LesKaribous/Karibous-2025-PAMI/README.md

# Project-Template
Template de projet avec documentation
