LesKaribous/Karibous-2025-PAMI/ECAD/MiniAmpli-2025/DFR0299/DFR0299.step

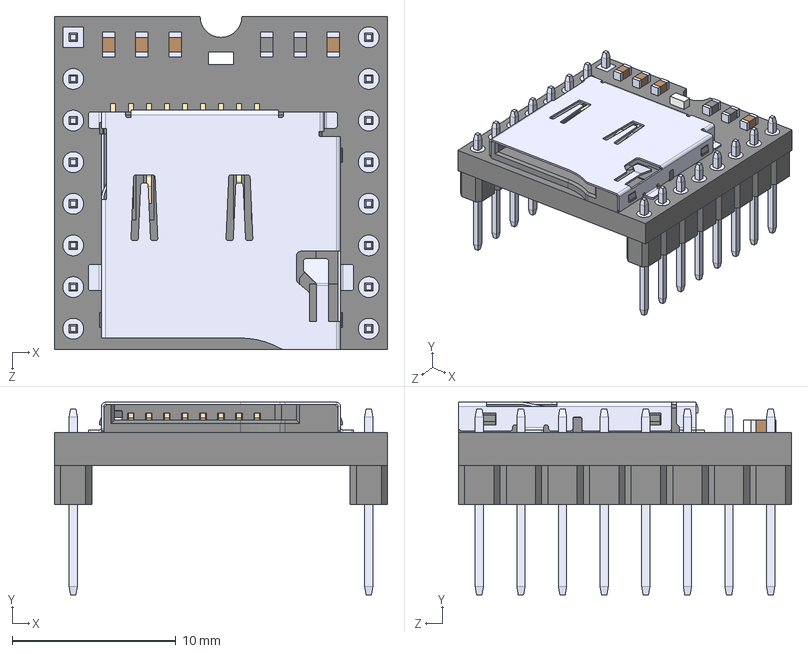
[picture p1: CAD file, 2025-03-02]
ECAD/MiniAmpli-2025/DFR0299/DFR0299.step
20.3 x 11.8 x 20.3 mm
