LesKaribous/Karibous-2025-PAMI/MCAD/3dprint/3dPrint-PAMI-2025.3mf

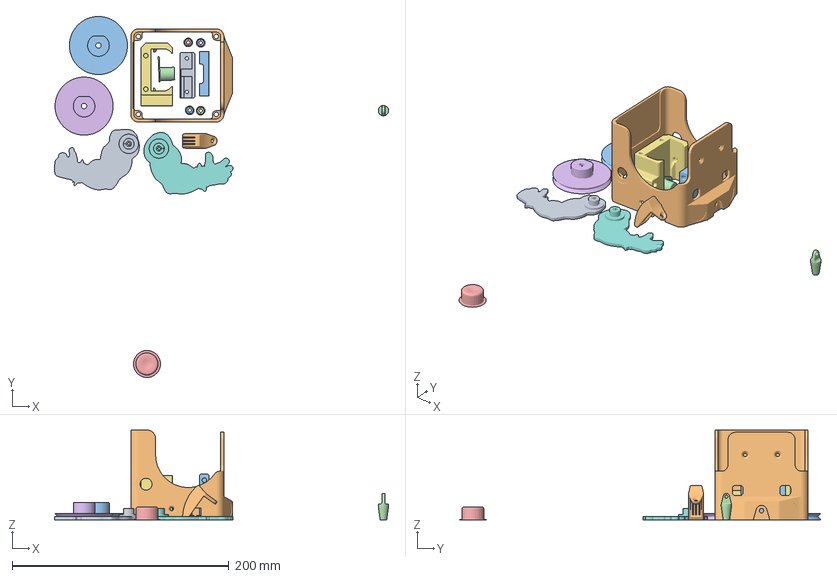
[picture p2: CAD file, 2024-11-29]
MCAD/3dprint/3dPrint-PAMI-2025.3mf
308.8 x 333.4 x 83.0 mm
PAMI-2025-Bras.stl
PAMI-2025-Bras02.stl
