LesKaribous/Karibous-2025-PAMI/MCAD/electronics/support-sensor.FCStd

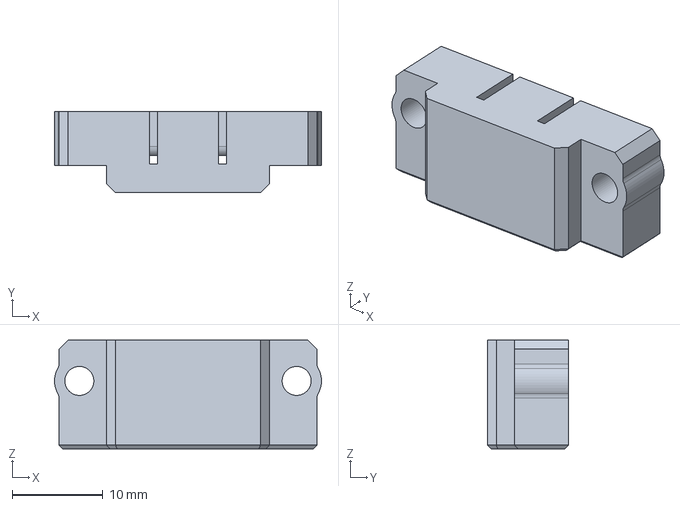
[picture p3: CAD file, 2025-04-25]
MCAD/electronics/support-sensor.FCStd
29.5 x 9.00 x 12.0 mm
