LesKaribous/Karibous-2025-PAMI/MCAD/exports/PAMI-2025-MotorisationRoue60mm.step

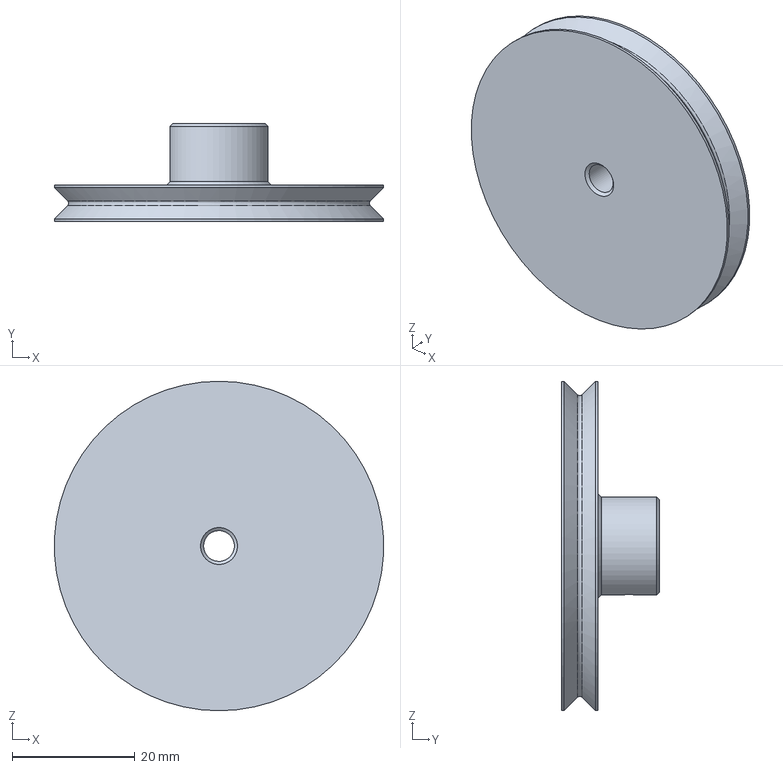
[picture p4: CAD file, 2024-11-04]
MCAD/exports/PAMI-2025-MotorisationRoue60mm.step
53.5 x 16.0 x 53.6 mm
