LesKaribous/Karibous-2025-PAMI/MCAD/mini-ampli/mini-ampli-2025.FCStd

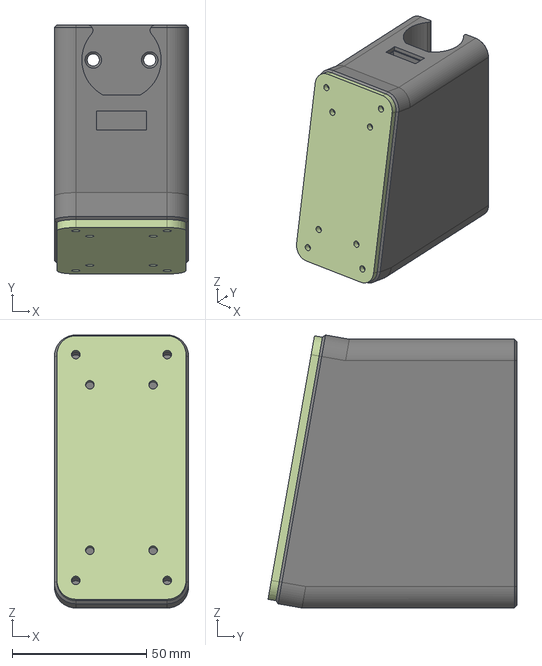
[picture p5: CAD file, 2025-03-02]
MCAD/mini-ampli/mini-ampli-2025.FCStd
50.0 x 92.6 x 101.6 mm
Grille
