LesKaribous/Karibous-2025-PAMI/MCAD/prototypes/proto-01.FCStd

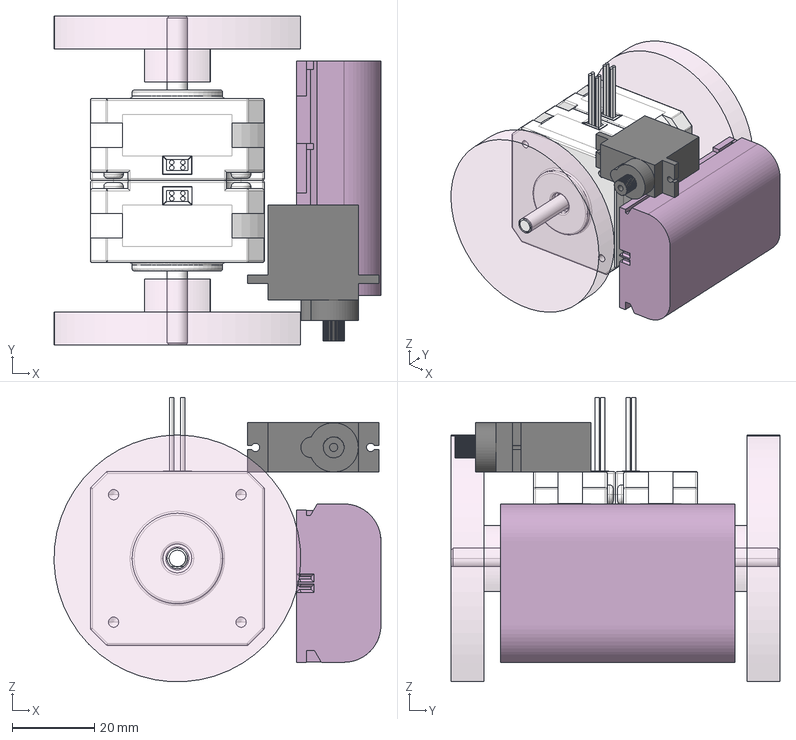
[picture p6: CAD file, 2024-11-02]
MCAD/prototypes/proto-01.FCStd
79.5 x 80.0 x 69.1 mm
17HS08-1004S x 2
Roue60mm x 2
mg90s
CanonLPE6-Canon
