LesKaribous/Karibous-2025-PAMI/MCAD/electronics/mg90s.step

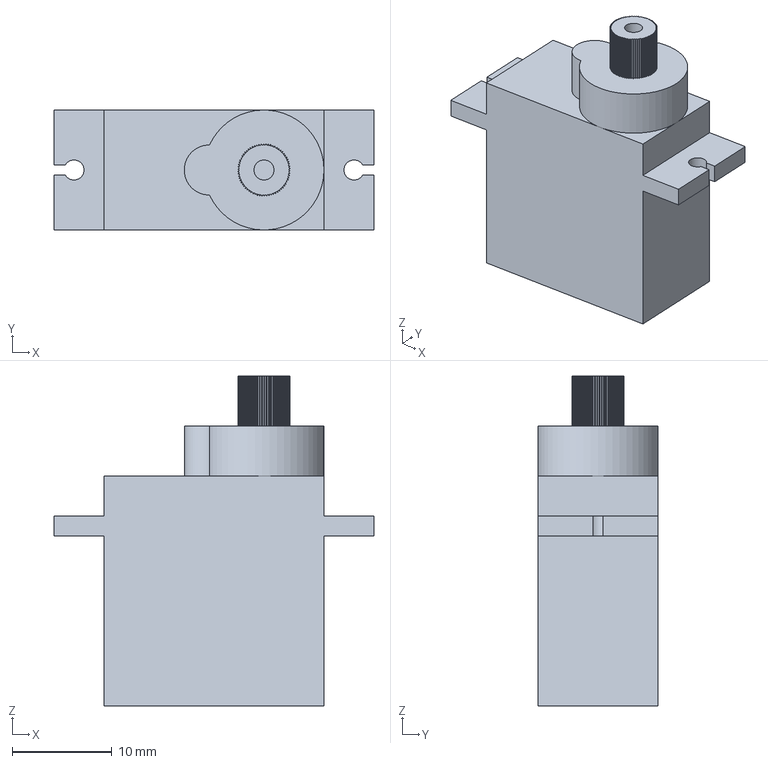
[picture p7: CAD file, 2024-10-12]
MCAD/electronics/mg90s.step
32.0 x 12.0 x 33.0 mm
