LesKaribous/Karibous-2025-PAMI/MCAD/electronics/17HS08-1004S.step

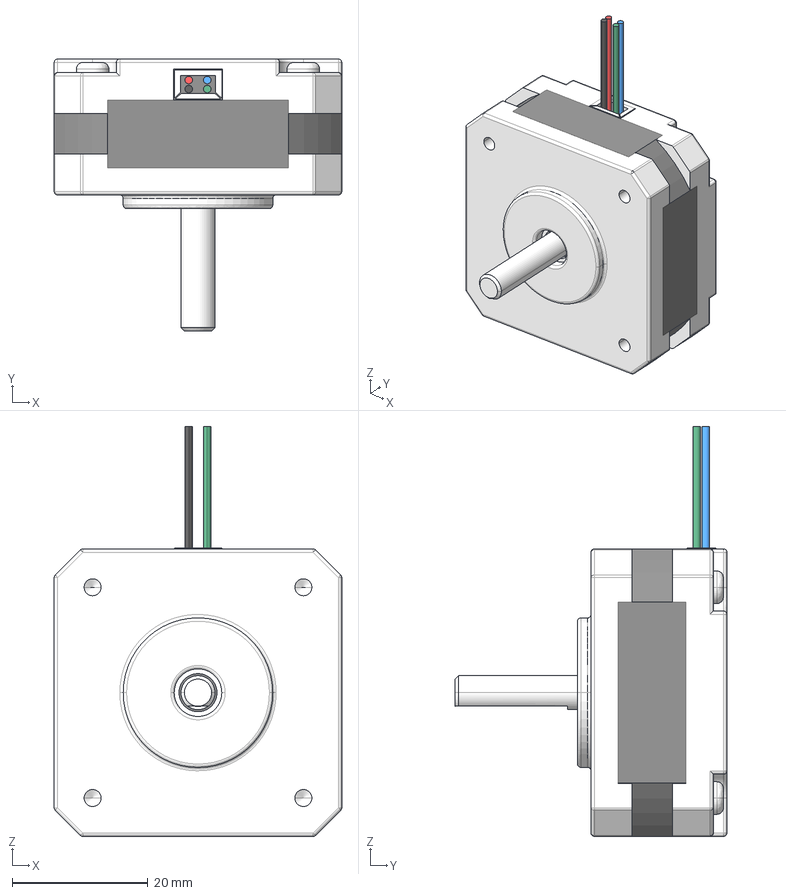
[picture p8: CAD file, 2024-10-11]
MCAD/electronics/17HS08-1004S.step
42.3 x 40.0 x 60.3 mm
