LesKaribous/Karibous-2025-PAMI/ECAD/MainBoard-PAMI-2025/MainBoard-PAMI-2025.kicad_pcb

## KiCad design ECAD/MainBoard-PAMI-2025/MainBoard-PAMI-2025.kicad_pcb (2025-06-07)

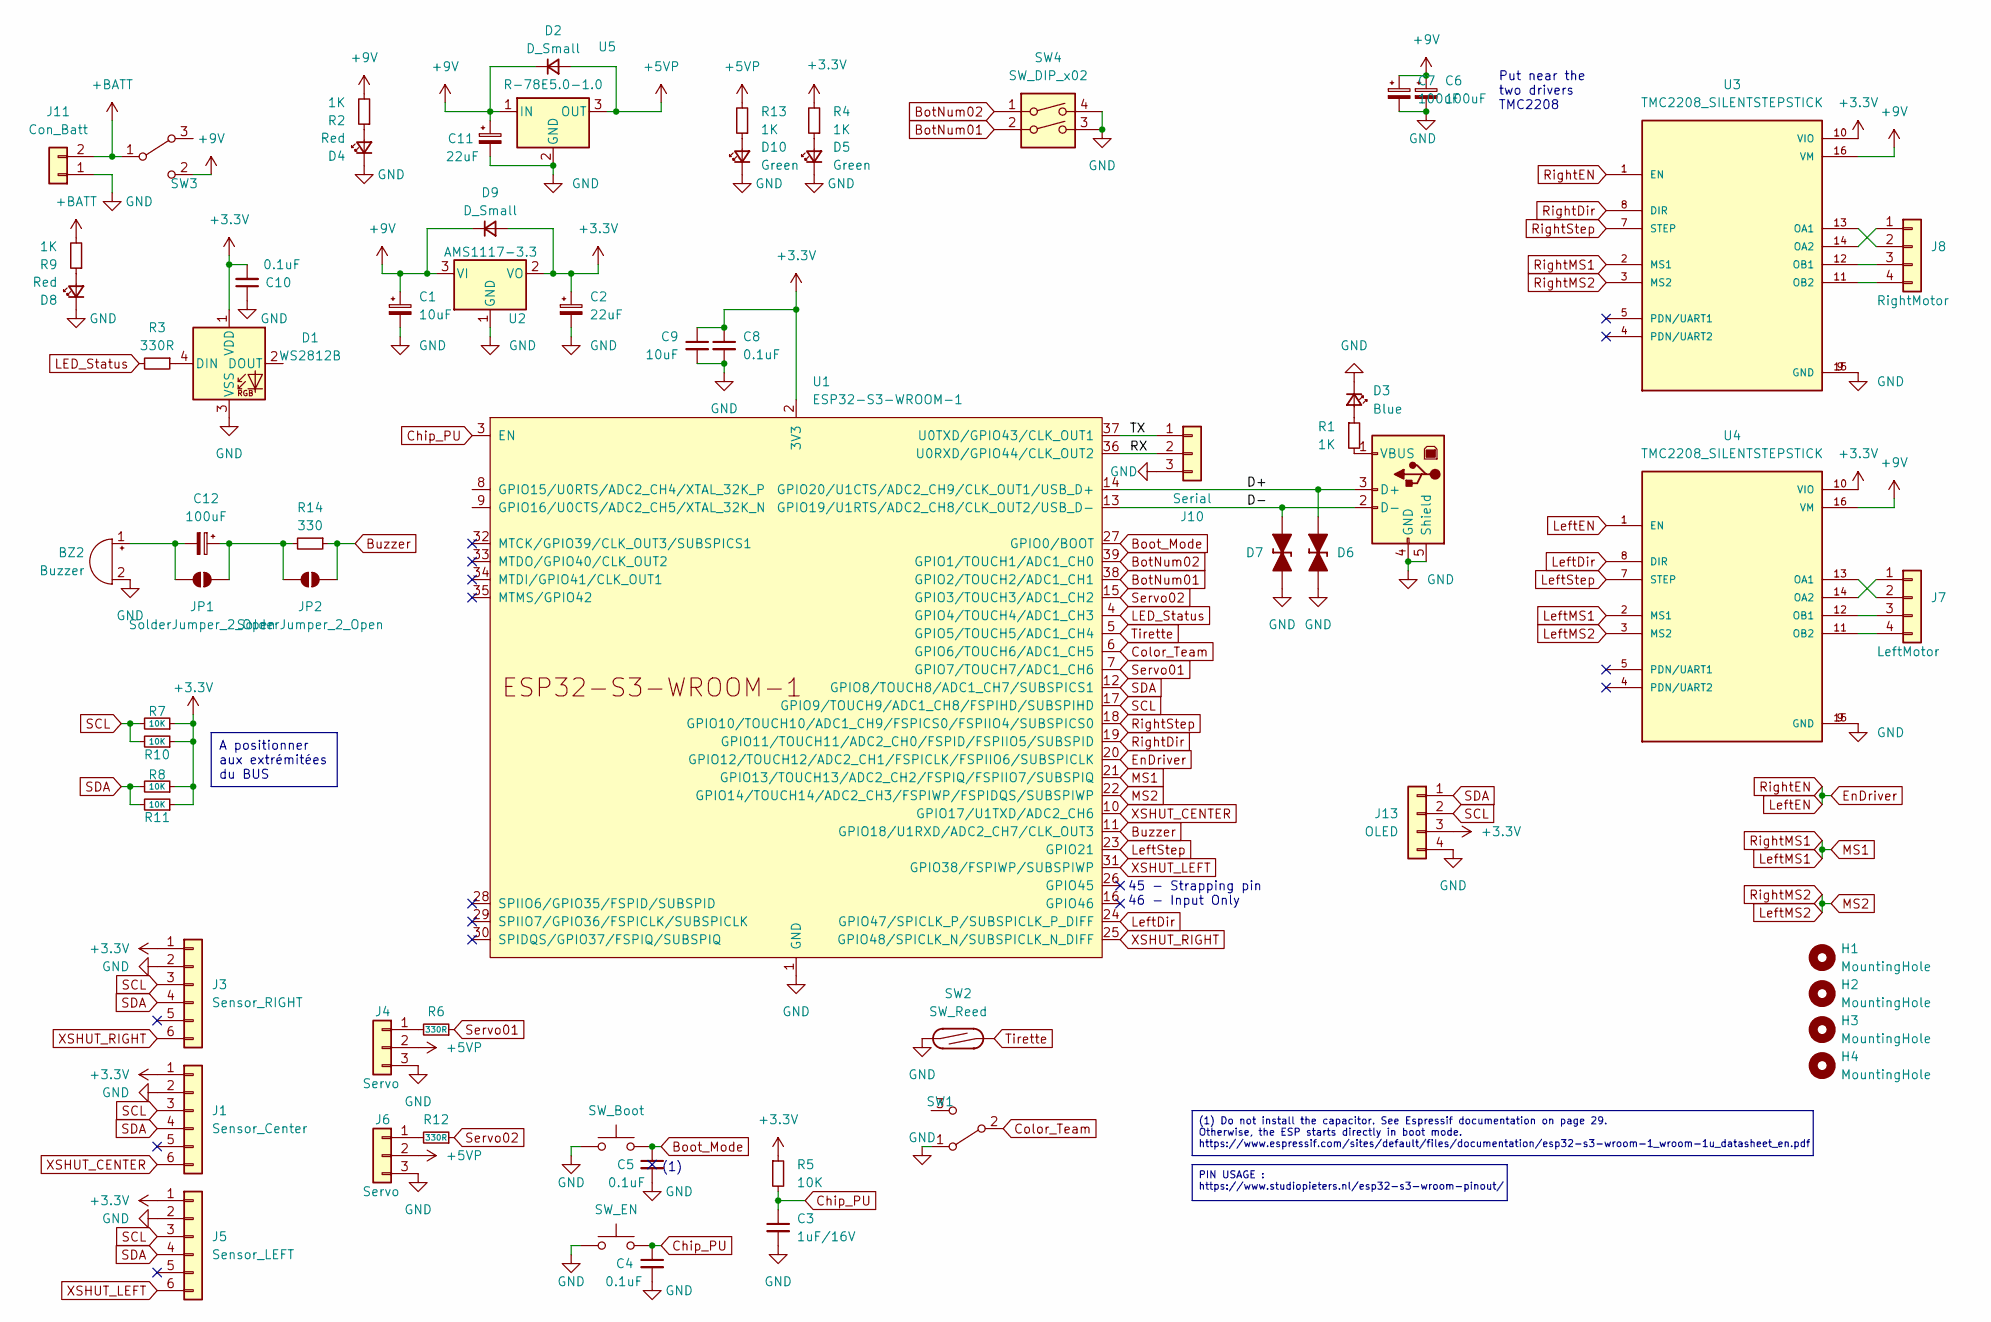
[picture p9: schematic MainBoard-PAMI-2025.kicad_sch]

Parts:
BZ2: Buzzer; Buzzer_12x9.5RM7.6
C1: 10uF; CP_Elec_5x5.4
C2: 22uF; CP_EIA-3528-12_Kemet-T_Pad1.50x2.35mm_HandSolder
C3: 1uF/16V; C_1206_3216Metric
C4, C5, C10: 0.1uF; C_1206_3216Metric
C6, C7: 100uF; CP_Radial_D8.0mm_P3.50mm
C8: 0.1uF; C_1206_3216Metric_Pad1.33x1.80mm_HandSolder
C9: 10uF; C_1206_3216Metric_Pad1.33x1.80mm_HandSolder
C11: 22uF; CP_Elec_5x5.4
C12: 100uF; CP_Elec_5x5.4
D1: WS2812B; LED_WS2812B_PLCC4_5.0x5.0mm_P3.2mm
D2, D9: D_Small; D_SMA_Handsoldering
D3: Blue; LED_1206_3216Metric
D4, D8: Red; LED_1206_3216Metric
D5, D10: Green; LED_1206_3216Metric
D6, D7: D_TVS_Bidirectional_Generic; D_SOD-523
H1, H2, H3, H4: MountingHole; MountingHole_3.2mm_M3
J1: Sensor_Center; VL53 Bottom Entry Version
J2: USB_B; USB_B_Lumberg_2411_02_Horizontal
J3: Sensor_RIGHT; VL53 Bottom Entry Version
J4, J6: Servo; PinHeader_1x03_P2.54mm_Vertical
J5: Sensor_LEFT; VL53 Bottom Entry Version
J7: LeftMotor; PinHeader_1x04_P2.54mm_Vertical
J8: RightMotor; PinHeader_1x04_P2.54mm_Vertical
J10: Serial; PinHeader_1x03_P2.54mm_Vertical
J11: Con_Batt; Molex_KK-254_AE-6410-02A_1x02_P2.54mm_Vertical
J13: OLED; PinSocket_1x04_P2.54mm_Vertical
JP1, JP2: SolderJumper_2_Open; SolderJumper-2_P1.3mm_Open_RoundedPad1.0x1.5mm
R1, R2, R4, R9, R13: 1K; R_1206_3216Metric_Pad1.30x1.75mm_HandSolder
R3, R6, R12: 330R; R_1206_3216Metric_Pad1.30x1.75mm_HandSolder
R5, R7, R8, R10, R11: 10K; R_1206_3216Metric_Pad1.30x1.75mm_HandSolder
R14: 330; R_1206_3216Metric_Pad1.30x1.75mm_HandSolder
SW1: SW_SPDT; SK-12D10 1P2T
SW2: SW_Reed; SW_SPST_REED_CT05-XXXX-G1
SW3: SW_SPDT; UB16SKW03N-C
SW4: SW_DIP_x02; SW_DIP_SPSTx02_Slide_9.78x7.26mm_W7.62mm_P2.54mm
SWBoot1: SW_Boot; SW_SPST_CK_RS282G05A3
SWEn1: SW_EN; SW_SPST_CK_RS282G05A3
U1: ESP32-S3-WROOM-1; ESP32-S3-WROOM-1U
U2: AMS1117-3.3; SOT-223-3_TabPin2
U3, U4: TMC2208_SILENTSTEPSTICK; Step-Stick Driver Bottom Entry Version
U5: R-78E5.0-1.0; Converter_DCDC_RECOM_R-78E-0.5_THT

Connections:
+3.3V: C2.1, C8.1, C9.1, C10.2, D1.1 (VDD), D9.2 (A), J1.1, J3.1, J5.1, J13.3, R4.2, R5.1, R7.1, R8.1, R10.1, R11.1, U1.2 (3V3), U2.2 (VO), U3.10 (VIO), U4.10 (VIO); also elsewhere on the board
+5VP: D2.2 (A), J4.2, J6.2, R13.2, U5.3 (OUT)
+9V: C1.1, C6.1, C7.1, C11.1, D2.1 (K), D9.1 (K), R2.2, SW3.2 (C), U2.3 (VI), U3.16 (VM), U4.16 (VM), U5.1 (IN)
+BATT: J11.2, R9.2, SW3.1 (B)
/D+: D6.2 (A), J2.3 (D+), U1.14 (GPIO20/U1CTS/ADC2_CH9/CLK_OUT1/USB_D+)
/D-: D7.2 (A), J2.2 (D-), U1.13 (GPIO19/U1RTS/ADC2_CH8/CLK_OUT2/USB_D-)
/RX: J10.2, U1.36 (U0RXD/GPIO44/CLK_OUT2)
/TX: J10.1, U1.37 (U0TXD/GPIO43/CLK_OUT1)
Boot_Mode: C5.1, SWBoot1.2, U1.27 (GPIO0/BOOT)
BotNum01: SW4.2, U1.38 (GPIO2/TOUCH2/ADC1_CH1)
BotNum02: SW4.1, U1.39 (GPIO1/TOUCH1/ADC1_CH0)
Buzzer: JP2.2 (B), R14.1, U1.11 (GPIO18/U1RXD/ADC2_CH7/CLK_OUT3)
Chip_PU: C3.1, C4.1, R5.2, SWEn1.2, U1.3 (EN)
Color_Team: SW1.2 (B), U1.6 (GPIO6/TOUCH6/ADC1_CH5)
EnDriver: U1.20 (GPIO12/TOUCH12/ADC2_CH1/FSPICLK/FSPIIO6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), U3.1 (EN), U4.1 (EN)
GND: BZ2.2 (-), C1.2, C2.2, C3.2, C4.2, C5.2, C6.2, C7.2, C8.2, C9.2, C10.1, C11.2, D1.3 (VSS), D3.1 (K), D4.1 (K), D5.1 (K), D6.1 (K), D7.1 (K), D8.1 (K), D10.1 (K), H1.1, H2.1, H3.1, H4.1, J1.2, J2.4 (GND), J2.5 (Shield), J3.2, J4.3, J5.2, J6.3, J10.3, J11.1, J13.4, SW1.1 (A), SW4.3, SW4.4, SWBoot1.1, SWEn1.1, U1.1 (GND), U1.40 (GND), U1.41 (GND), U2.1 (GND), U3.9 (GND), U3.15 (GND), U4.9 (GND), U4.15 (GND), U5.2 (GND); also elsewhere on the board
LED_Status: R3.2, U1.4 (GPIO4/TOUCH4/ADC1_CH3)
LeftDir: U1.24 (GPIO47/SPICLK_P/SUBSPICLK_P_DIFF), U4.8 (DIR)
LeftMS1: U1.21 (GPIO13/TOUCH13/ADC2_CH2/FSPIQ/FSPIIO7/S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), U3.2 (MS1), U4.2 (MS1)
LeftMS2: U1.22 (GPIO14/TOUCH14/ADC2_CH3/FSPIWP/FSPIDQS/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), U3.3 (MS2), U4.3 (MS2)
LeftStep: U1.23 (GPIO21), U4.7 (STEP)
unnamed: BZ2.1 (+), C12.2, JP1.1 (A)
unnamed: D1.4 (DIN), R3.1
unnamed: D3.2 (A), R1.1
unnamed: D4.2 (A), R2.1
unnamed: D5.2 (A), R4.1
unnamed: D8.2 (A), R9.1
unnamed: D10.2 (A), R13.1
unnamed: J2.1 (VBUS), R1.2
unnamed: J4.1, R6.2
unnamed: J6.1, R12.2
unnamed: J7.1, U4.14 (OA2)
unnamed: J7.2, U4.13 (OA1)
unnamed: J7.3, U4.12 (OB1)
unnamed: J7.4, U4.11 (OB2)
unnamed: J8.1, U3.14 (OA2)
unnamed: J8.2, U3.13 (OA1)
unnamed: J8.3, U3.12 (OB1)
unnamed: J8.4, U3.11 (OB2)
unnamed: C12.1, JP1.2 (B), JP2.1 (A), R14.2
RightDir: U1.19 (GPIO11/TOUCH11/ADC2_CH0/FSPID/FSPIIO5/S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), U3.8 (DIR)
RightStep: U1.18 (GPIO10/TOUCH10/ADC1_CH9/FSPICS0/FSPIIO4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), U3.7 (STEP)
SCL: J1.3, J3.3, J5.3, J13.2, R7.2, R10.2, U1.17 (GPIO9/TOUCH9/ADC1_CH8/FSPIHD/SUBSPIHD)
SDA: J1.4, J3.4, J5.4, J13.1, R8.2, R11.2, U1.12 (GPIO8/TOUCH8/ADC1_CH7/SUBSPICS1)
Servo01: R6.1, U1.7 (GPIO7/TOUCH7/ADC1_CH6)
Servo02: R12.1, U1.15 (GPIO3/TOUCH3/ADC1_CH2)
Tirette: SW2.2, U1.5 (GPIO5/TOUCH5/ADC1_CH4); also elsewhere on the board
XSHUT_CENTER: J1.6, U1.10 (GPIO17/U1TXD/ADC2_CH6)
XSHUT_LEFT: J5.6, U1.31 (GPIO38/FSPIWP/SUBSPIWP)
XSHUT_RIGHT: J3.6, U1.25 (GPIO48/SPICLK_N/SUBSPICLK_N_DIFF)

Notes on the sheet:
PIN USAGE : https://www.studiopieters.nl/esp32-s3-wroom-pinout/
A positionner aux extrémitées du BUS
(1) Do not install the capacitor. See Espressif documentation on page 29. Otherwise, the ESP starts directly in boot mode. https://www.espressif.com/sites/default/files/documentation/esp32-s3-wroom-1_wroom-1u_datasheet_en.pdf
Put near the two drivers TMC2208
(1)
45 - Strapping pin 46 - Input Only

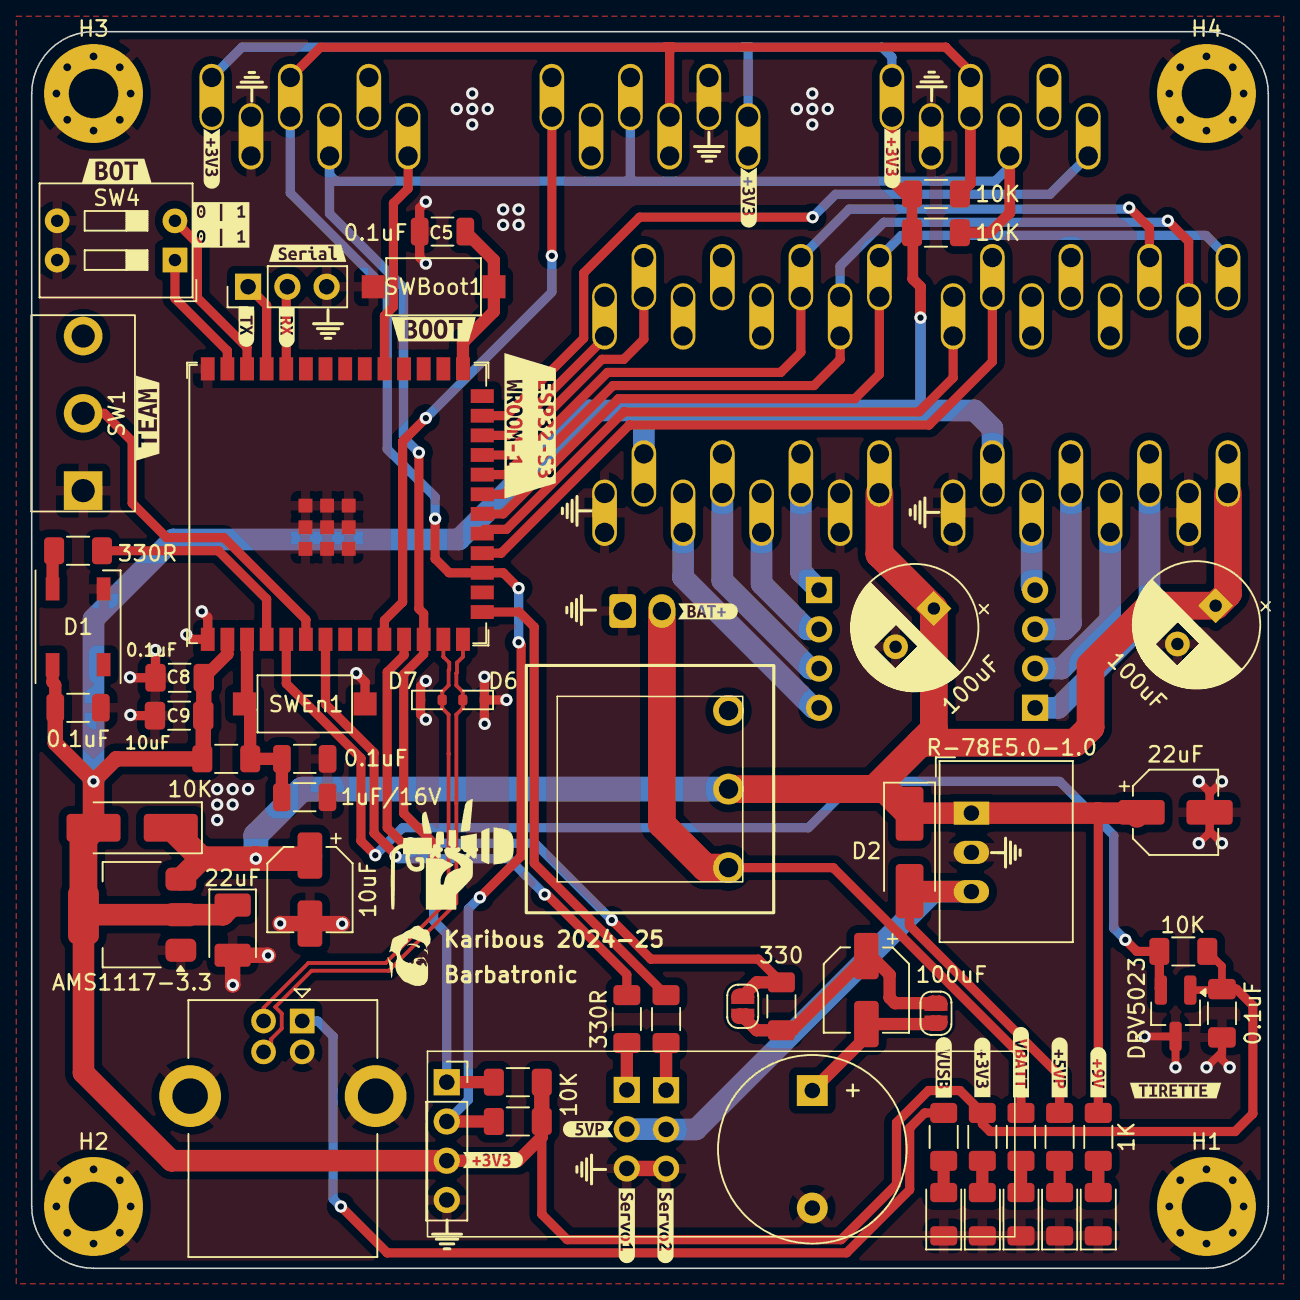
[picture p10: board MainBoard-PAMI-2025.kicad_pcb from above]

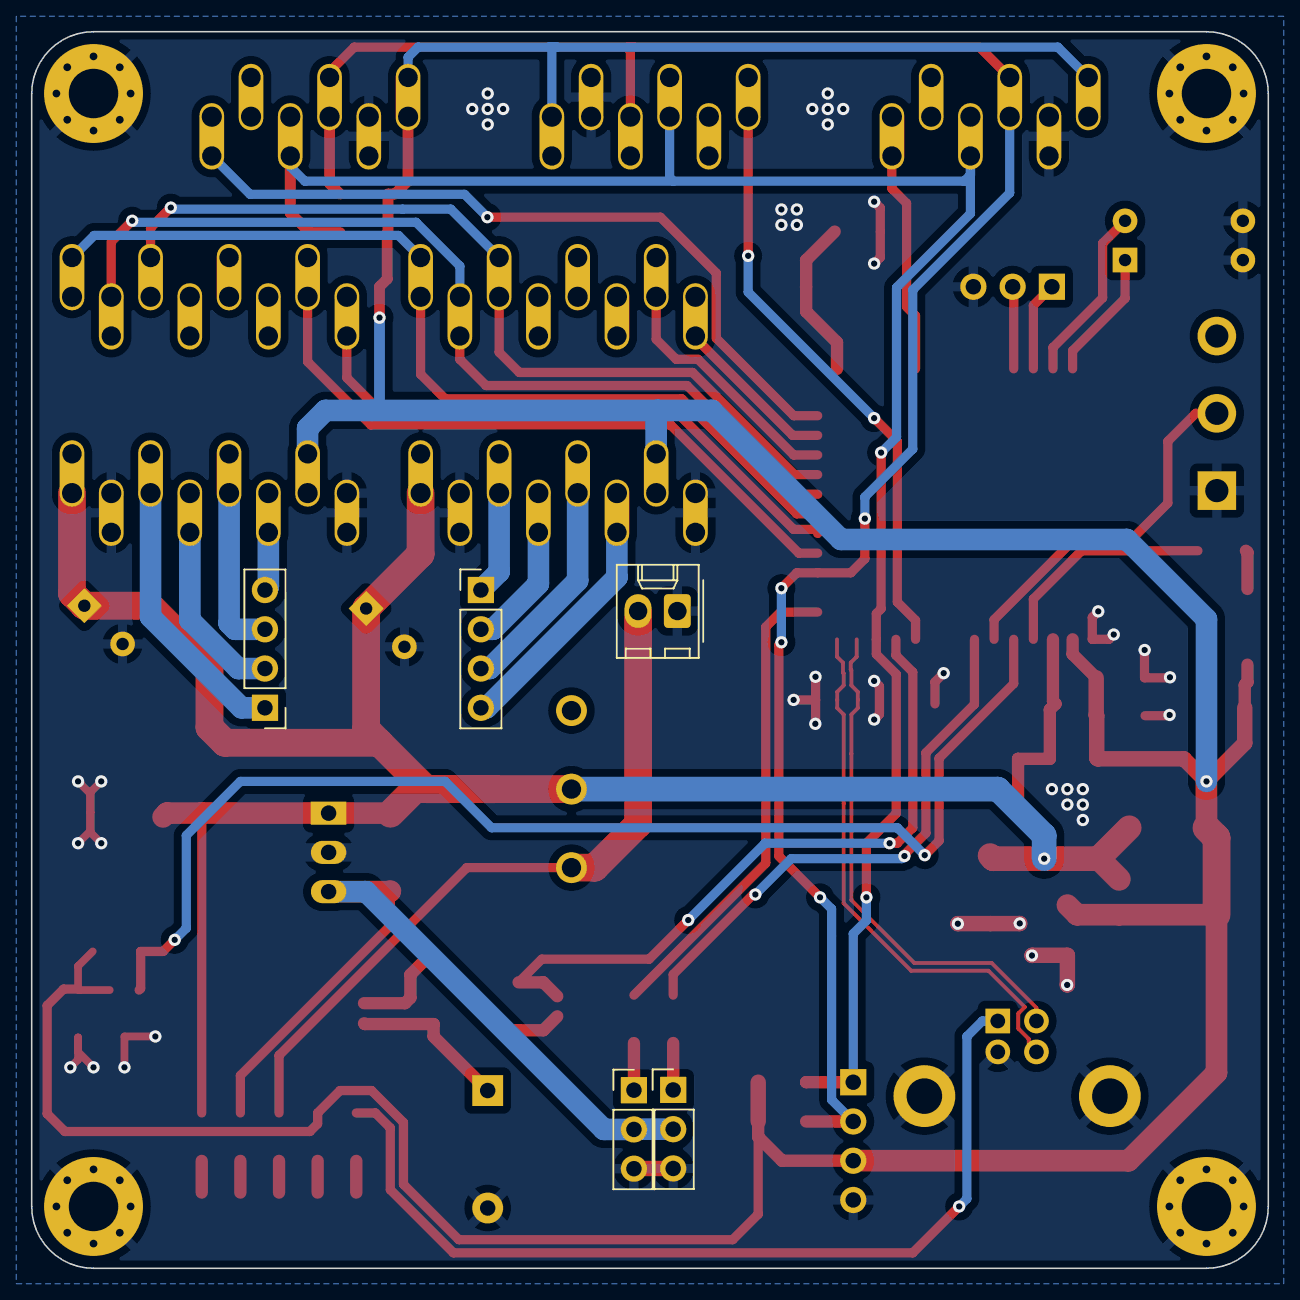
[picture p11: board MainBoard-PAMI-2025.kicad_pcb from below]

Board: 2 copper layers, 80.0 x 80.0 mm, 89 parts (8 on the bottom side), 50 nets.

Other parts of the board:
C13: 0.1uF; C_1206_3216Metric_Pad1.33x1.80mm_HandSolder
R15: 10K; R_1206_3216Metric_Pad1.30x1.75mm_HandSolder
U6: DRV5023; SOT-23_Handsoldering
kibuzzard-670C04A5, kibuzzard-670C04A5#2, kibuzzard-670C04A5#3, kibuzzard-670C04A5#4: G***; kibuzzard-670C04A5
kibuzzard-670C04EF: G***; kibuzzard-670C04EF
kibuzzard-670C05E9: G***; kibuzzard-670C05E9
kibuzzard-670C07A3: G***; kibuzzard-670C07A3
kibuzzard-670C07E1: G***; kibuzzard-670C07E1
kibuzzard-670C23C9: G***; kibuzzard-670C23C9
kibuzzard-670C045B: G***; kibuzzard-670C045B
kibuzzard-670C047F: G***; kibuzzard-670C047F
kibuzzard-670C057C: G***; kibuzzard-670C057C
kibuzzard-670C058F: G***; kibuzzard-670C058F
kibuzzard-670C060B: G***; kibuzzard-670C060B
kibuzzard-670C061D: G***; kibuzzard-670C061D
kibuzzard-670C077D: G***; kibuzzard-670C077D
kibuzzard-670C0418: G***; kibuzzard-670C0418
kibuzzard-670C0436: G***; kibuzzard-670C0436
kibuzzard-670C0507: G***; kibuzzard-670C0507
kibuzzard-670C0614: G***; kibuzzard-670C0614
kibuzzard-670C0624: G***; kibuzzard-670C0624
kibuzzard-670C0798: G***; kibuzzard-670C0798

Their connections:
+3.3V: C13.1, R15.2, U6.1 (VCC); also elsewhere on the board
GND: C13.2, U6.3 (GND); also elsewhere on the board
Tirette: R15.1, U6.2 (OUT); also elsewhere on the board
