LesKaribous/Karibous-2025-PAMI/ECAD/MiniAmpli-2025/MiniAmpli-2025.kicad_pcb

## KiCad design ECAD/MiniAmpli-2025/MiniAmpli-2025.kicad_pcb (2025-01-29)

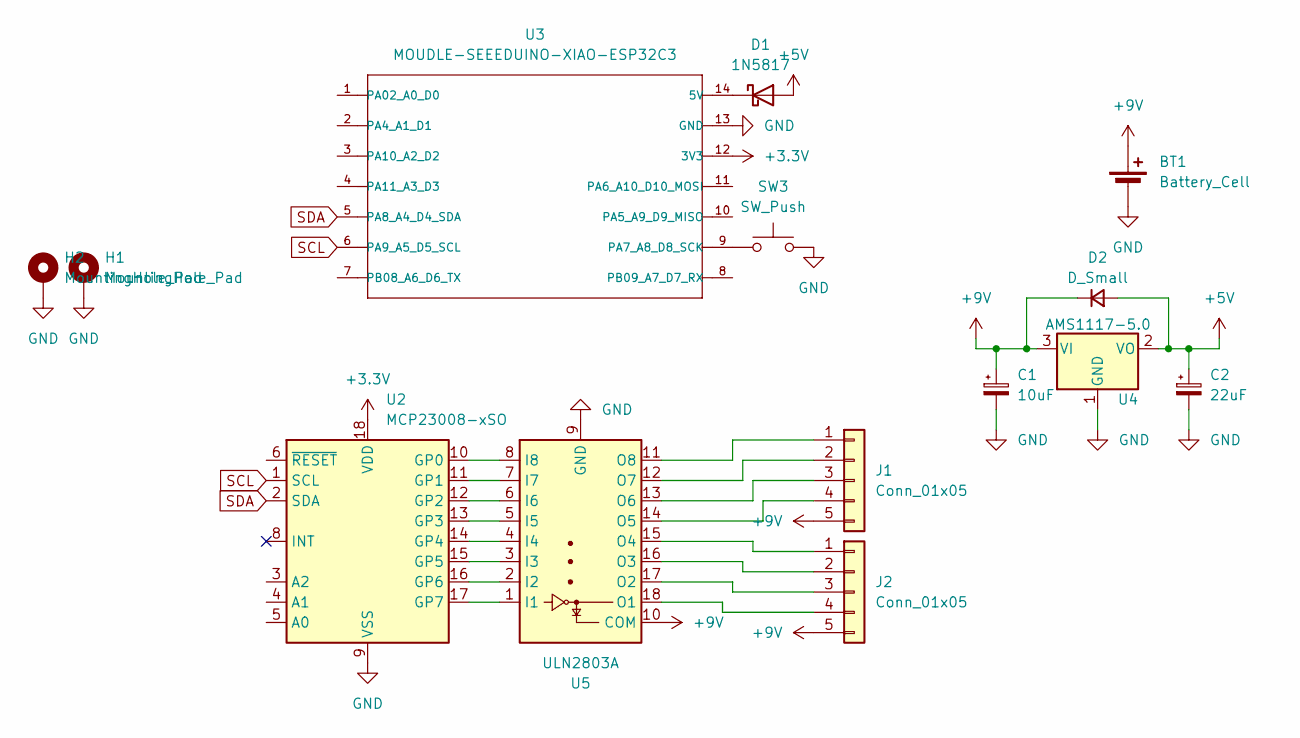
[picture p12: schematic MiniAmpli-2025.kicad_sch]

Parts:
BT1: Battery_Cell; BatteryHolder_Eagle_12BH611-GR
C1: 10uF; CP_Elec_5x5.4
C2: 22uF; CP_EIA-3528-12_Kemet-T_Pad1.50x2.35mm_HandSolder
D1: 1N5817; D_DO-41_SOD81_P7.62mm_Horizontal
D2: D_Small; D_SMA_Handsoldering
H1, H2: MountingHole_Pad; MountingHole_3.2mm_M3_Pad_Via
J1, J2: Conn_01x05; JST_XH_B5B-XH-A_1x05_P2.50mm_Vertical
SW3: SW_Push; SW_XKB_DM1-16UP-1
U2: MCP23008-xSO; SOIC-18W_7.5x11.6mm_P1.27mm
U3: MOUDLE-SEEEDUINO-XIAO-ESP32C3; MOUDLE14P-SMD-2.54-21X17.8MM
U4: AMS1117-5.0; SOT-223-3_TabPin2
U5: ULN2803A; SOIC-18W_7.5x11.6mm_P1.27mm

Connections:
+3.3V: U2.18 (VDD), U3.12 (3V3)
+5V: C2.1, D1.2 (A), D2.2 (A), U4.2 (VO)
+9V: BT1.1 (+), C1.1, D2.1 (K), J1.5, J2.5, U4.3 (VI), U5.10 (COM)
GND: BT1.2 (-), C1.2, C2.2, H1.1, H2.1, SW3.2, U2.9 (VSS), U3.13 (GND), U4.1 (GND), U5.9 (GND)
unnamed: D1.1 (K), U3.14 (5V)
unnamed: J1.1, U5.11 (O8)
unnamed: J1.2, U5.12 (O7)
unnamed: J1.3, U5.13 (O6)
unnamed: J1.4, U5.14 (O5)
unnamed: J2.1, U5.15 (O4)
unnamed: J2.2, U5.16 (O3)
unnamed: J2.3, U5.17 (O2)
unnamed: J2.4, U5.18 (O1)
unnamed: U2.10 (GP0), U5.8 (I8)
unnamed: U2.11 (GP1), U5.7 (I7)
unnamed: U2.12 (GP2), U5.6 (I6)
unnamed: U2.13 (GP3), U5.5 (I5)
unnamed: U2.14 (GP4), U5.4 (I4)
unnamed: U2.15 (GP5), U5.3 (I3)
unnamed: U2.16 (GP6), U5.2 (I2)
unnamed: U2.17 (GP7), U5.1 (I1)
unnamed: SW3.1, U3.9 (PA7_A8_D8_SCK)
SCL: U2.1 (SCL), U3.6 (PA9_A5_D5_SCL)
SDA: U2.2 (SDA), U3.5 (PA8_A4_D4_SDA)

Board: 2 copper layers, 14 parts (3 on the bottom side), 24 nets, no tracks yet.
