LesKaribous/Karibous-2025-PAMI/FIRMWARE/Firmware-PAMI-2025/src/match.cpp

// 
#include "match.h"

long elapsedTime  = 0;
long startTime    = 0;

int matchState = MATCH_WAIT;

int getMatchState(){
    return matchState;
}
void setMatchState(int _state){
    matchState = _state;
}
void startMatch(){
    startTime = millis();
    matchState = MATCH_BEGIN;
}
void updateMatchTime(){
  if(getMatchState() == MATCH_BEGIN || getMatchState() == PAMI_RUN){
    elapsedTime = millis() - startTime ;
    if(elapsedTime>= TIME_END_MATCH)
    {
        setMatchState(PAMI_STOP);
        debug("Match End");
    }
    else if(elapsedTime>= TIME_START_MATCH && getMatchState() == MATCH_BEGIN)
    {
        setMatchState(PAMI_RUN);
        debug("Match Run");
    }
    else if(getMatchState() == MATCH_BEGIN)
    {
        infoLCD(String((TIME_START_MATCH-elapsedTime)/1000) + " sec");
        debug("Waiting...");
    }
  }
}
long getElapsedTime(){
    return elapsedTime ;
}
long getStartTime(){
    return startTime ;
}
void pause(long millisecondes) {
    unsigned long startPause = millis(); // Enregistre le temps de début de la pause

    while (millis() - startPause < millisecondes) {
        updateMatchTime(); // Met à jour l'état du match

        if (getMatchState() == PAMI_STOP) {
            debug("Pause interrompue : match terminé");
            break; // Sort de la pause si le match est terminé
        }

        // Ajout d'un petit délai non bloquant pour éviter de monopoliser le CPU
        delayMicroseconds(500);  
    }
}
