LesKaribous/Karibous-2025-PAMI/(commit log)

2024-06-01 NewBoard 2025
    [MainBoard-PAMI-2025.kicad_pcb, MainBoard-PAMI-2025.kicad_sch]
2024-06-01 update PCB
    [MainBoard-PAMI-2025.kicad_pcb, MainBoard-PAMI-2025.kicad_sch]
2024-06-01 Everything that need to be here :)
    [MainBoard-PAMI-2025.kicad_pcb, MainBoard-PAMI-2025.kicad_sch]
2024-06-01 Quick routing
    [MainBoard-PAMI-2025.kicad_pcb, MainBoard-PAMI-2025.kicad_sch]
2024-06-02 Optimize routing
    [MainBoard-PAMI-2025.kicad_pcb, MainBoard-PAMI-2025.kicad_sch]
2024-09-30 Change switch + regulator + Servo Power
    [MainBoard-PAMI-2025.kicad_pcb, MainBoard-PAMI-2025.kicad_sch]
2024-10-11 add sensor center
    [MainBoard-PAMI-2025.kicad_pcb, MainBoard-PAMI-2025.kicad_sch]
2024-10-11 new sensor position - new PCB size
    [MainBoard-PAMI-2025.kicad_pcb]
2024-10-11 first prototype
    [17HS08-1004S.step, proto-01.FCStd]
2024-10-12 Update Live 206
    Update Battery
    Add Recom 5V
    Add ASM1117
    Add capacitor
    Change sensor header
    Move components
    [MainBoard-PAMI-2025.kicad_pcb, MainBoard-PAMI-2025.kicad_sch, mg90s.step, proto-01.FCStd]
2024-10-13 Add buzzer
    [MainBoard-PAMI-2025.kicad_pcb, MainBoard-PAMI-2025.kicad_sch]
2024-10-13 routage + silkscreen
    [MainBoard-PAMI-2025.kicad_pcb, MainBoard-PAMI-2025.kicad_sch]
2024-10-13 Change for DRV5023 - New 3D
    [MainBoard-PAMI-2025.kicad_pcb]
2024-10-13 New halle effect sensor for tirette
2024-11-02 WIP PAMI 2025
    [MainBoard-PAMI-2025.kicad_pcb, proto-01.FCStd]
2024-11-03 new carter, arm and side support
2024-11-04 export for CNC
    [PAMI-2025-MotorisationRoue60mm.step]
2024-11-04 Add plan for laser
2024-11-04 fix holes for servomotors
2024-11-05 add bom
2024-11-16 change PCB position / carter
2024-11-21 fix sensor - Test sensor and tirette
    [ihm.cpp, sensors.cpp]
2024-11-23 Live 210 - Modif Roue, Bride connecteur et tirette
2024-11-27 update tirette and carter
2024-11-28 Optimize time | Fiesta mode and actuators new values
2024-11-28 add new arm and modify BAU
2024-11-28 Introducing Fiesta ! 🎉🎉
2024-11-29 Update 3D print files
    [3dPrint-PAMI-2025.3mf]
2024-12-02 update second arm
2024-12-30 backup Kicad
2025-01-28 Correct paths for case-sensitive filesystems
    [MainBoard-PAMI-2025.kicad_pcb]
2025-01-29 Nex PCB Mini Pami
    [Mini-PAMI-2025.kicad_pcb, Mini-PAMI-2025.kicad_sch]
2025-01-29 minor update
    [Mini-PAMI-2025.kicad_pcb, Mini-PAMI-2025.kicad_sch]
2025-02-26 new carter and spacer
2025-02-28 add holes for arms
2025-03-02 mini ampli
    [DFR0299.step, MiniAmpli-2025.kicad_pcb, MiniAmpli-2025.kicad_sch, mini-ampli-2025.FCStd]
2025-03-04 improve end match if opponent detected
    Le robot saute maintenant à la fin de match même si il détecte un robot adverse et reste bloqué
2025-03-04 Superstar Match is Ready 🎉🎉
2025-04-25 live 225 - add support for sensors and debug
    [support-sensor.FCStd]
2025-05-18 WIP - Synchro actuators and sensors filtering
2025-06-07 sensor filter - WIP
2026-01-13 New pcb - Ninja SIMA
